madhavkrishnanks/EV1527_-Task/images/scope_frame.png

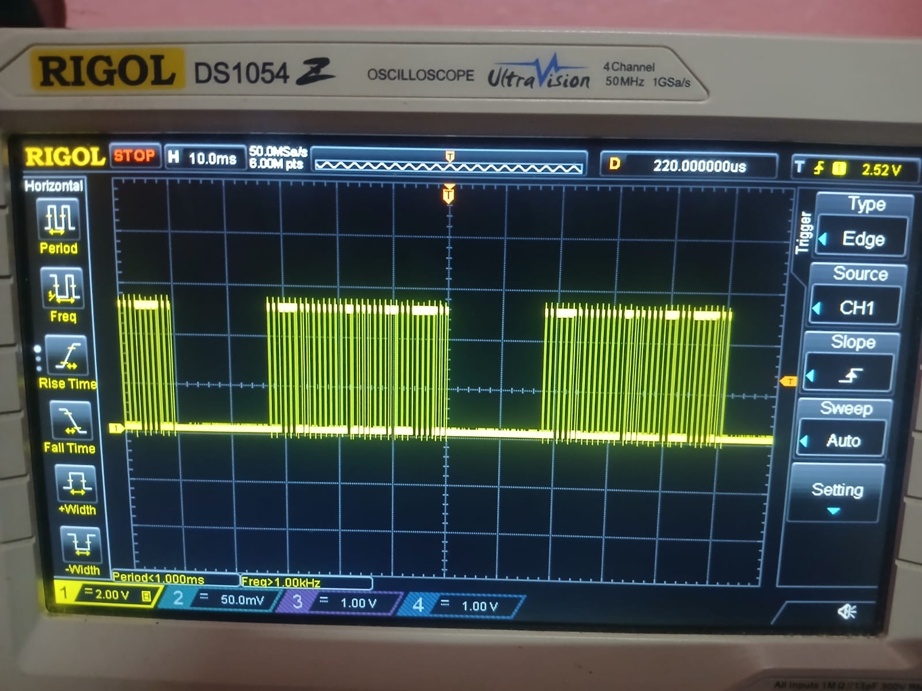
images/scope_frame.png
