madhavkrishnanks/EV1527_-Task/(commit log)

2026-11-14 docs: add wiki source page for EV1527 baseband, RF link, decode and relay
2026-11-14 Synchronize neutral engineering phrasing, timing breakdown, and relay wording
